HartnettMatt/PersonalProjects/AudioBalancer/README.txt

THIS AUDIO PROJECT IS RUNNING ON AN ARDUINO NANO EVERY. THE HARDWARE FOR THE SLIDERS IS BASED ON A RADIOSHACK 4 CHANNEL STEREO SOUND MIXER. THE SOFTWARE ORGINATES FROM THE DEEJ PROJECT ON GITHUB, BUT HAS BEEN MODIFIED BY ME FOR THE LINEARIZATION OF THE RADIOSHACK SLIDERS.
