HartnettMatt/PersonalProjects/Bathroom Organizer/FullOrganizer.FCStd

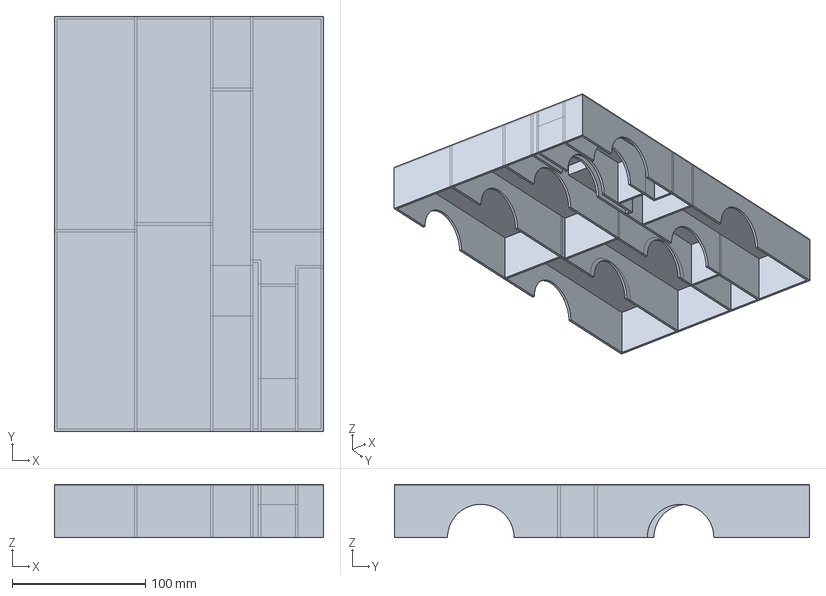
[picture p5: CAD file, 2025-11-11]
Bathroom Organizer/FullOrganizer.FCStd
202.0 x 312.0 x 40.0 mm
