HartnettMatt/PersonalProjects/Bathroom Organizer/Moisturizer.FCStd

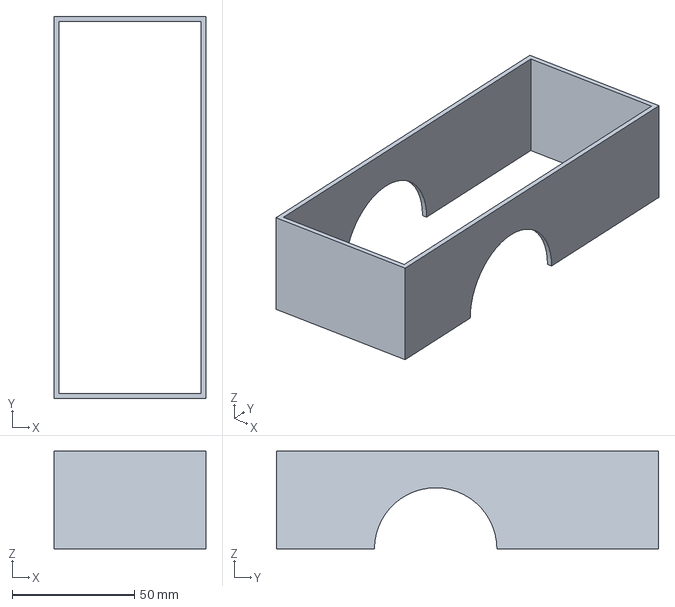
[picture p6: CAD file, 2025-11-11]
Bathroom Organizer/Moisturizer.FCStd
62.0 x 156.0 x 40.0 mm
