HartnettMatt/PersonalProjects/ESPHome/MotionDetector/3D/Enclosure.FCStd

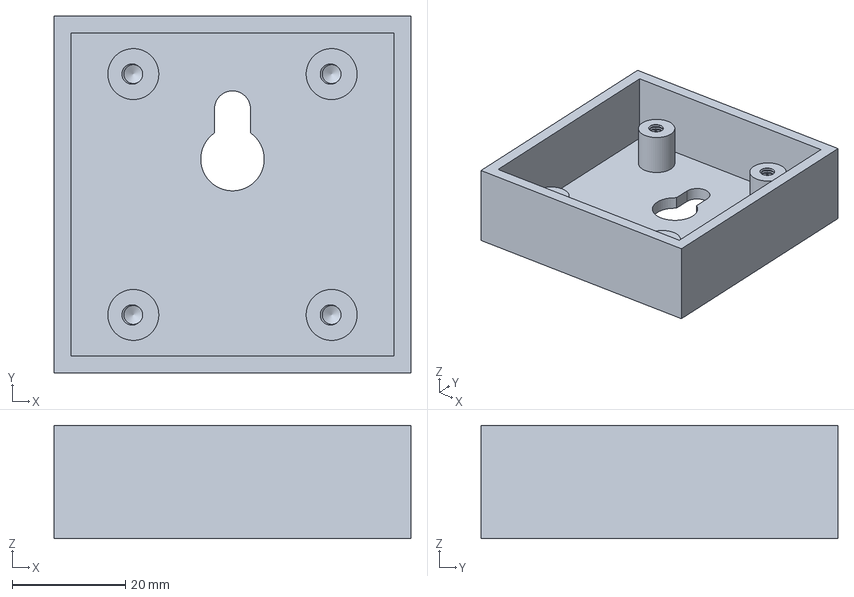
[picture p7: CAD file, 2025-05-09]
ESPHome/MotionDetector/3D/Enclosure.FCStd
63.0 x 63.0 x 20.0 mm
