HartnettMatt/PersonalProjects/ESPHome/MotionDetector/PCB/Parts/61302011821/6130XX11821_61302011821.step

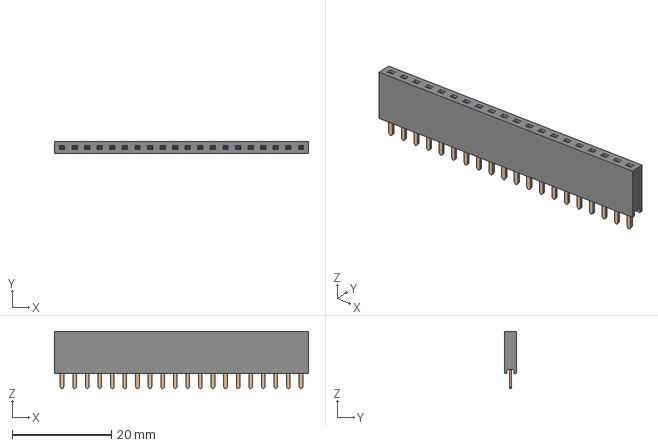
[picture p8: CAD file, 2024-12-29]
ESPHome/MotionDetector/PCB/Parts/61302011821/6130XX11821_61302011821.step
51.3 x 2.50 x 11.6 mm
6130xx11821_PIN x 20
