HartnettMatt/PersonalProjects/ESPHome/RGBStrip/PCB/AO3400A/AO3400A.step

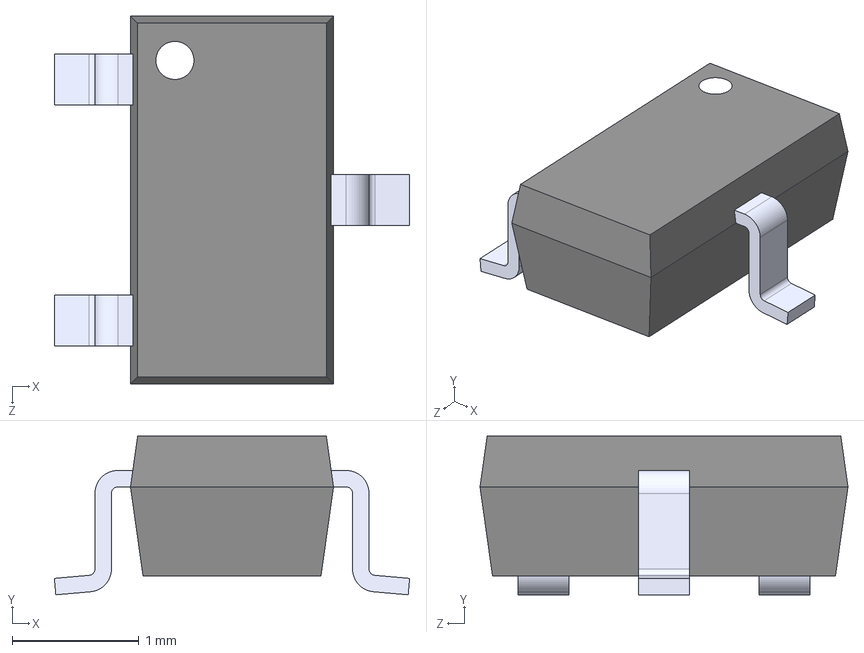
[picture p9: CAD file, 2025-08-09]
ESPHome/RGBStrip/PCB/AO3400A/AO3400A.step
2.80 x 1.25 x 2.90 mm
