HartnettMatt/PersonalProjects/Bathroom Organizer/Toothbrush.FCStd

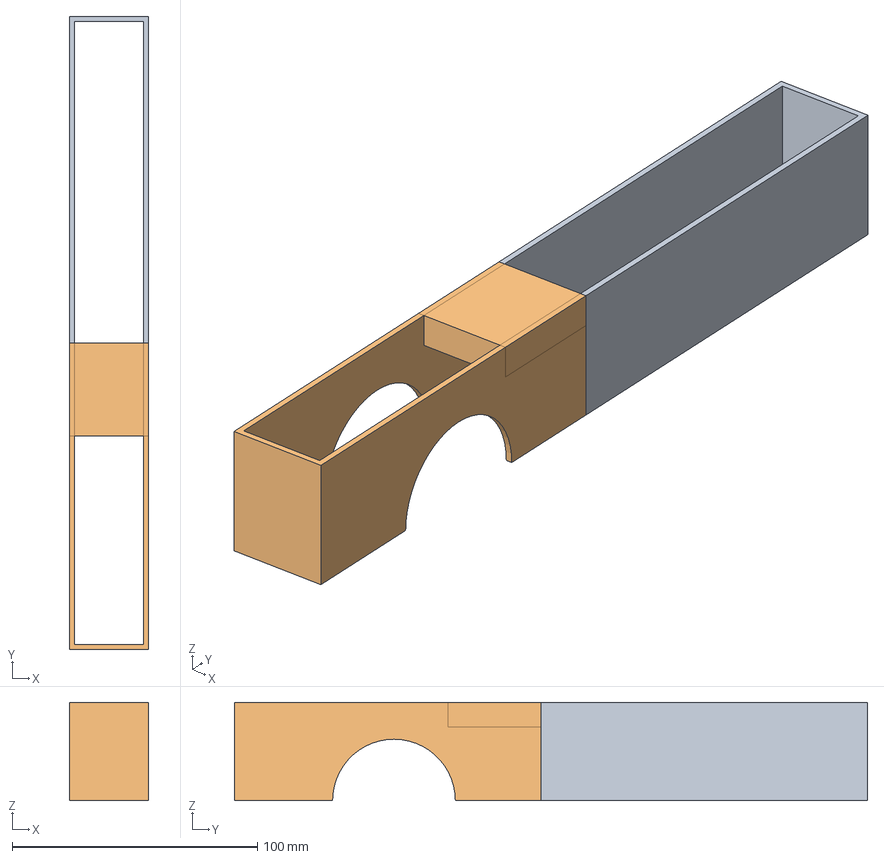
[picture p10: CAD file, 2025-11-11]
Bathroom Organizer/Toothbrush.FCStd
32.0 x 258.0 x 40.0 mm
Toothbrush001
