HartnettMatt/PersonalProjects/IRSender/IRSender.FCStd

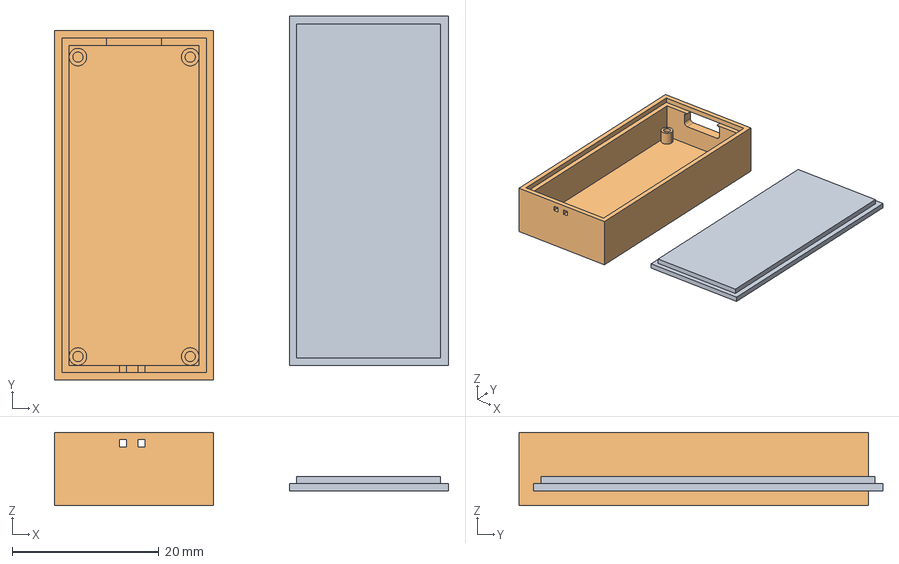
[picture p11: CAD file, 2025-05-13]
IRSender/IRSender.FCStd
53.7 x 49.6 x 10.0 mm
Lid
Box with LED cutout
