HartnettMatt/PersonalProjects/Bathroom Organizer/Razor.FCStd

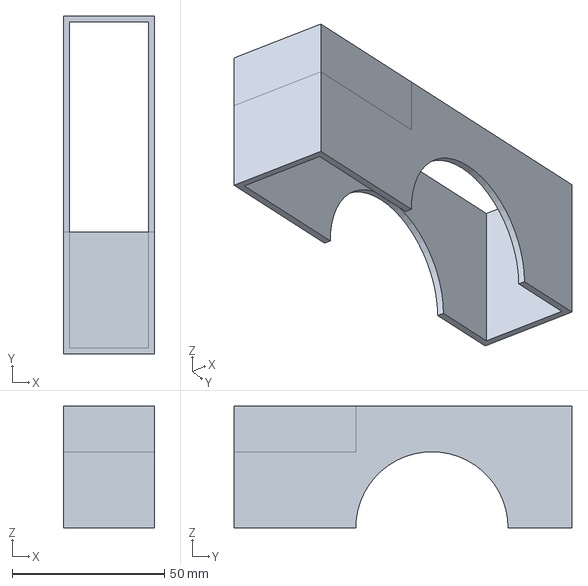
[picture p12: CAD file, 2025-03-21]
Bathroom Organizer/Razor.FCStd
30.0 x 111.0 x 40.0 mm
