HartnettMatt/PersonalProjects/Bathroom Organizer/Deodorent.FCStd

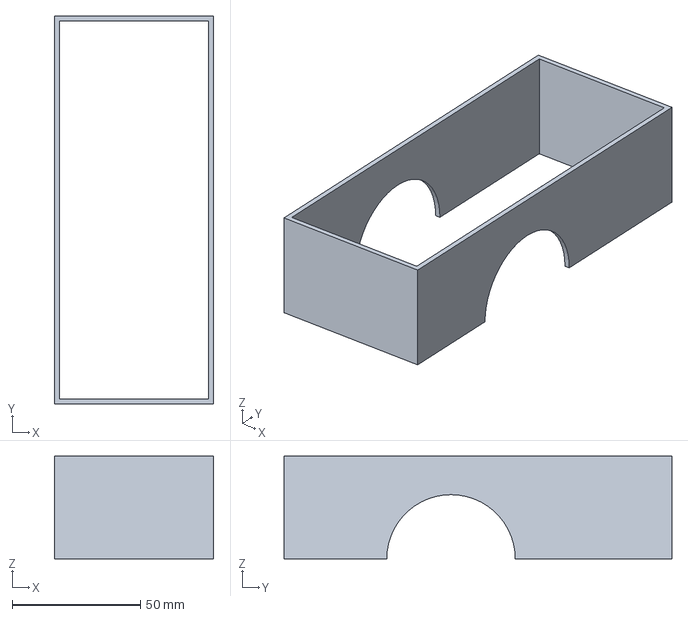
[picture p13: CAD file, 2025-03-21]
Bathroom Organizer/Deodorent.FCStd
62.0 x 151.0 x 40.0 mm
