HartnettMatt/PersonalProjects/IRSender/IRSender-Arduino Mount.stl

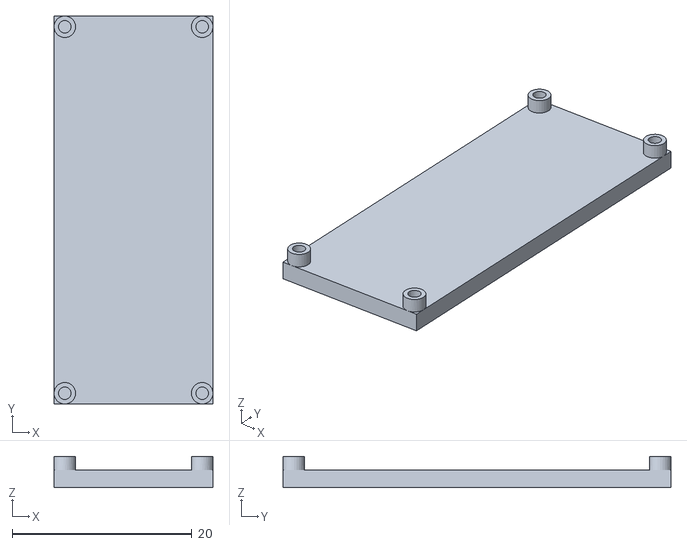
[picture p14: CAD file, 2025-05-13]
IRSender/IRSender-Arduino Mount.stl
17.7 x 43.2 x 3.50
