HartnettMatt/PersonalProjects/Bathroom Organizer/Toothbrush1.stl

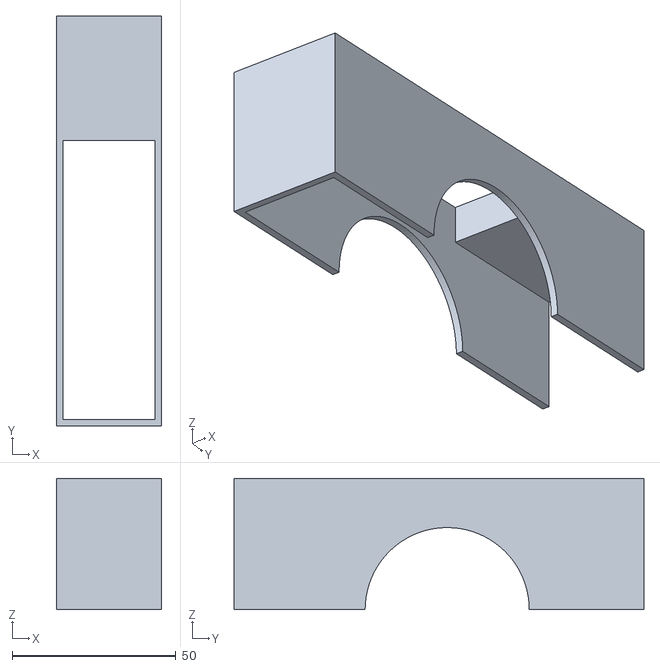
[picture p15: CAD file, 2025-03-21]
Bathroom Organizer/Toothbrush1.stl
32.0 x 125.0 x 40.0
