HartnettMatt/PersonalProjects/IRSender/IRSender-Arduino Box Lid.stl

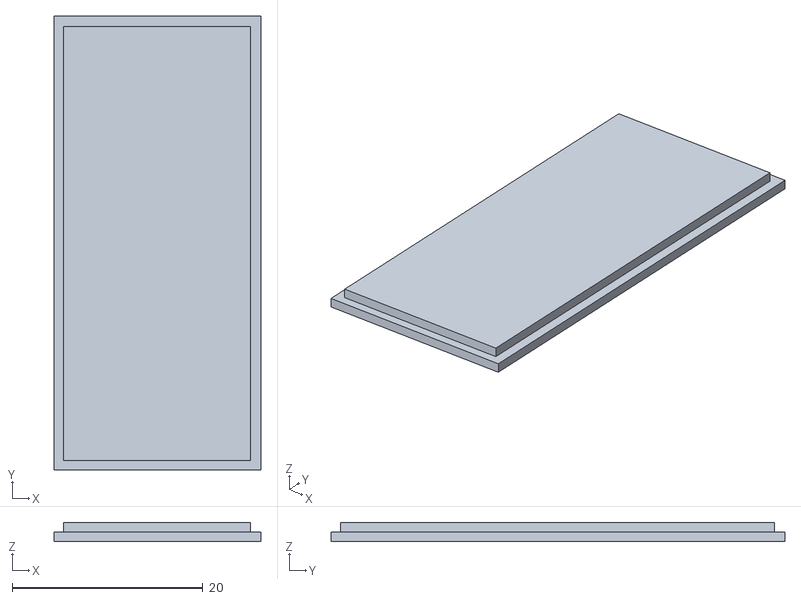
[picture p16: CAD file, 2025-05-13]
IRSender/IRSender-Arduino Box Lid.stl
21.7 x 47.6 x 2.00
