HartnettMatt/PersonalProjects/Bathroom Organizer/Bathroom Organizer.FCStd

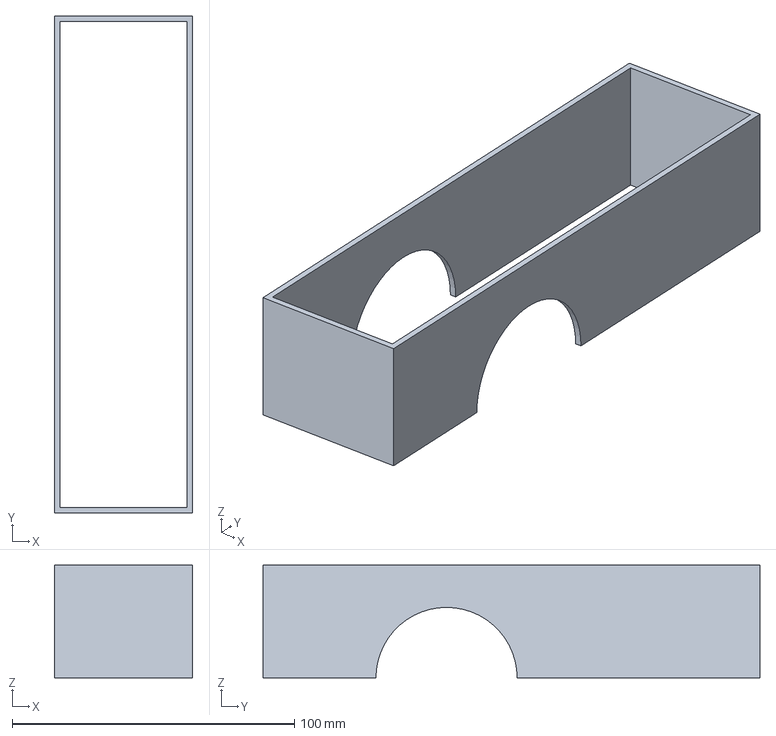
[picture p17: CAD file, 2025-03-21]
Bathroom Organizer/Bathroom Organizer.FCStd
49.0 x 176.0 x 40.0 mm
