HartnettMatt/PersonalProjects/Bathroom Organizer/Contacts.FCStd

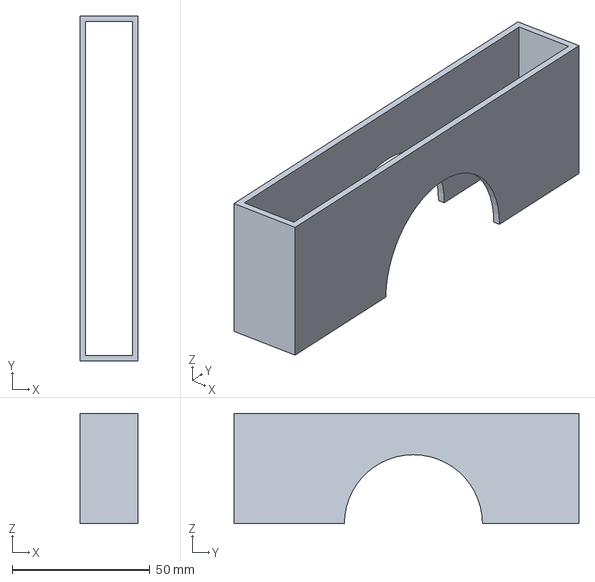
[picture p18: CAD file, 2025-03-21]
Bathroom Organizer/Contacts.FCStd
21.0 x 125.0 x 40.0 mm
