HartnettMatt/PersonalProjects/Bathroom Organizer/Toothbrush2.stl

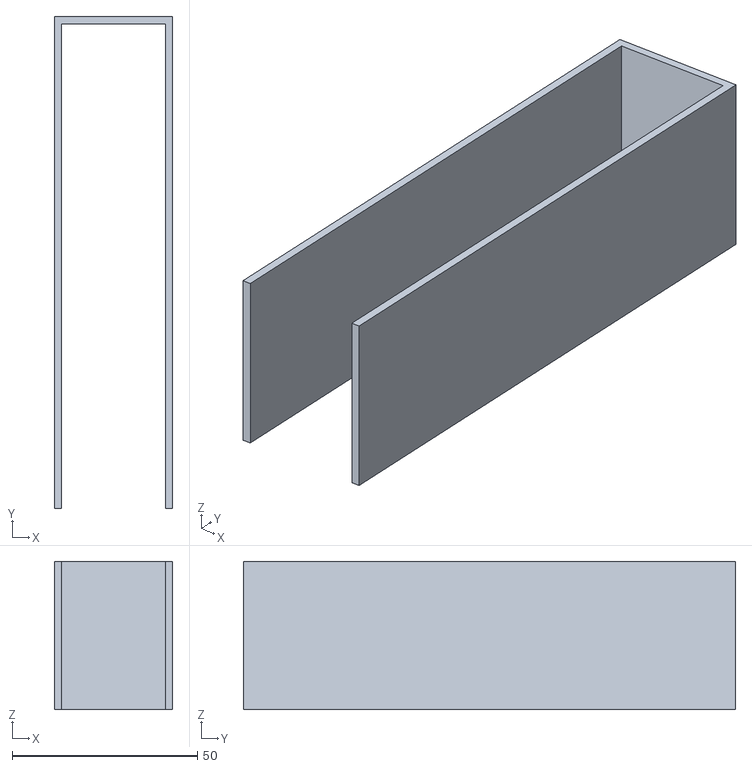
[picture p19: CAD file, 2025-03-21]
Bathroom Organizer/Toothbrush2.stl
32.0 x 133.0 x 40.0
