HartnettMatt/PersonalProjects/(list of files, cad)

Other CAD files:
PlantTrellis/PlantTrellis.FCStd
Bathroom Organizer/Contacts.stl
Bathroom Organizer/Deodorent.stl
Bathroom Organizer/FullOrganizer.stl
Bathroom Organizer/Moisturizer.stl
Bathroom Organizer/Razor.stl
Bathroom Organizer/Toothbrush.stl
ESPHome/MotionDetector/3D/Enclosure.stl
ESPHome/MotionDetector/PCB/Parts/215299-3/215299-3/3D/215299-3.stp
ESPHome/MotionDetector/PCB/Parts/215299-3/215299-3/Allegro/shdr3w78p0x254_1x3_772x252x850p.psm
ESPHome/MotionDetector/PCB/Parts/215299-3/215299-3/DEHDL/215299_3/chips/chips.prt
IRSender/IRSender-Arduino Box_v2.stl
IRSender/IRSender-Arduino Box_v3.stl
