HartnettMatt/PersonalProjects/Home Assistant/EVCharger/history.csv

entity_id | state | last_changed
sensor.us15_m2_16_32a_total_energy | 4.6 | 2025-09-01T06:00:00.000Z
sensor.us15_m2_16_32a_total_energy | 6.88 | 2025-09-01T07:00:00.000Z
sensor.us15_m2_16_32a_total_energy | 8.03 | 2025-09-01T08:00:00.000Z
sensor.us15_m2_16_32a_total_energy | 9.17 | 2025-09-01T09:00:00.000Z
sensor.us15_m2_16_32a_total_energy | 9.94 | 2025-09-01T10:00:00.000Z
sensor.us15_m2_16_32a_total_energy | 0 | 2025-09-01T11:00:00.000Z
sensor.us15_m2_16_32a_total_energy | 0 | 2025-09-01T12:00:00.000Z
sensor.us15_m2_16_32a_total_energy | 1.14 | 2025-09-01T23:00:00.000Z
sensor.us15_m2_16_32a_total_energy | 2.29 | 2025-09-02T00:00:00.000Z
sensor.us15_m2_16_32a_total_energy | 3.45 | 2025-09-02T01:00:00.000Z
sensor.us15_m2_16_32a_total_energy | 4.6 | 2025-09-02T02:00:00.000Z
sensor.us15_m2_16_32a_total_energy | 5.76 | 2025-09-02T03:00:00.000Z
sensor.us15_m2_16_32a_total_energy | 6.91 | 2025-09-02T04:00:00.000Z
sensor.us15_m2_16_32a_total_energy | 8.07 | 2025-09-02T05:00:00.000Z
sensor.us15_m2_16_32a_total_energy | 9.23 | 2025-09-02T06:00:00.000Z
sensor.us15_m2_16_32a_total_energy | 11.56 | 2025-09-02T07:00:00.000Z
sensor.us15_m2_16_32a_total_energy | 12.72 | 2025-09-02T08:00:00.000Z
sensor.us15_m2_16_32a_total_energy | 13.86 | 2025-09-02T09:00:00.000Z
sensor.us15_m2_16_32a_total_energy | 15 | 2025-09-02T10:00:00.000Z
sensor.us15_m2_16_32a_total_energy | 16.14 | 2025-09-02T11:00:00.000Z
sensor.us15_m2_16_32a_total_energy | 0 | 2025-09-02T12:00:00.000Z
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
sensor.us15_m2_16_32a_total_energy | 18.45 | 2025-09-29T11:19:06.562Z
sensor.us15_m2_16_32a_total_energy | 19.57 | 2025-09-29T12:11:52.048Z
sensor.us15_m2_16_32a_total_energy | 20.7 | 2025-09-29T13:04:37.589Z
sensor.us15_m2_16_32a_total_energy | 21.84 | 2025-09-29T13:57:23.212Z
sensor.us15_m2_16_32a_total_energy | 22.97 | 2025-09-29T14:50:08.533Z
sensor.us15_m2_16_32a_total_energy | 24.11 | 2025-09-29T15:42:53.564Z
sensor.us15_m2_16_32a_total_energy | 25.26 | 2025-09-29T16:35:38.912Z
sensor.us15_m2_16_32a_total_energy | 26.4 | 2025-09-29T17:28:24.481Z
sensor.us15_m2_16_32a_total_energy | 27.48 | 2025-09-29T18:17:49.450Z
sensor.us15_m2_16_32a_total_energy | 0.0 | 2025-09-29T19:07:37.825Z
