HartnettMatt/PersonalProjects/ESPHome/RGBStrip/PCB/ControlSchematic.asc

M1: nmos
M2: nmos
M3: nmos
Named nets: 0
