HartnettMatt/PersonalProjects/(list of files, drawings)

Other design files:
ESPHome/MotionDetector/PCB/Parts/215299-3/215299-3/Altium/215299-3.SchLib
ESPHome/MotionDetector/PCB/Parts/215299-3/215299-3/Altium/SHDR3W78P0X254_1X3_772X252X850P.PcbLib
