HartnettMatt/PersonalProjects/ESPHome/MotionDetector/PCB/MotionDetector/MotionDetector.kicad_pcb

## KiCad design ESPHome/MotionDetector/PCB/MotionDetector/MotionDetector.kicad_pcb (2024-12-29)

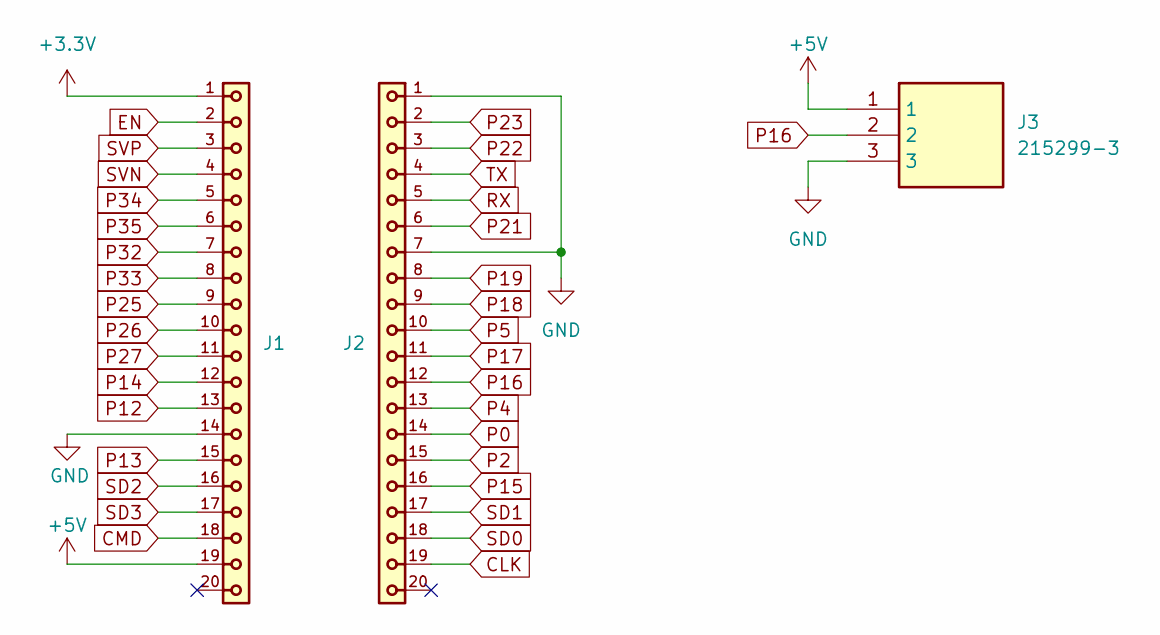
[picture p20: schematic MotionDetector.kicad_sch, ESPHome MotionDetector SCH]

Parts:
J1, J2: 61302011821; PART-NUMBER 61302011821
J3: 215299-3; SHDR3W78P0X254_1X3_772X252X850P; Mouser Part Number 571-215299-3

Connections:
+3.3V: J1.1
+5V: J1.19, J3.1
CLK: J2.19
CMD: J1.18
EN: J1.2
GND: J1.14, J2.1, J2.7, J3.3
P0: J2.14
P2: J2.15
P4: J2.13
P5: J2.10
P12: J1.13
P13: J1.15
P14: J1.12
P15: J2.16
P16: J2.12, J3.2
P17: J2.11
P18: J2.9
P19: J2.8
P21: J2.6
P22: J2.3
P23: J2.2
P25: J1.9
P26: J1.10
P27: J1.11
P32: J1.7
P33: J1.8
P34: J1.5
P35: J1.6
RX: J2.5
SD0: J2.18
SD1: J2.17
SD2: J1.16
SD3: J1.17
SVN: J1.4
SVP: J1.3
TX: J2.4

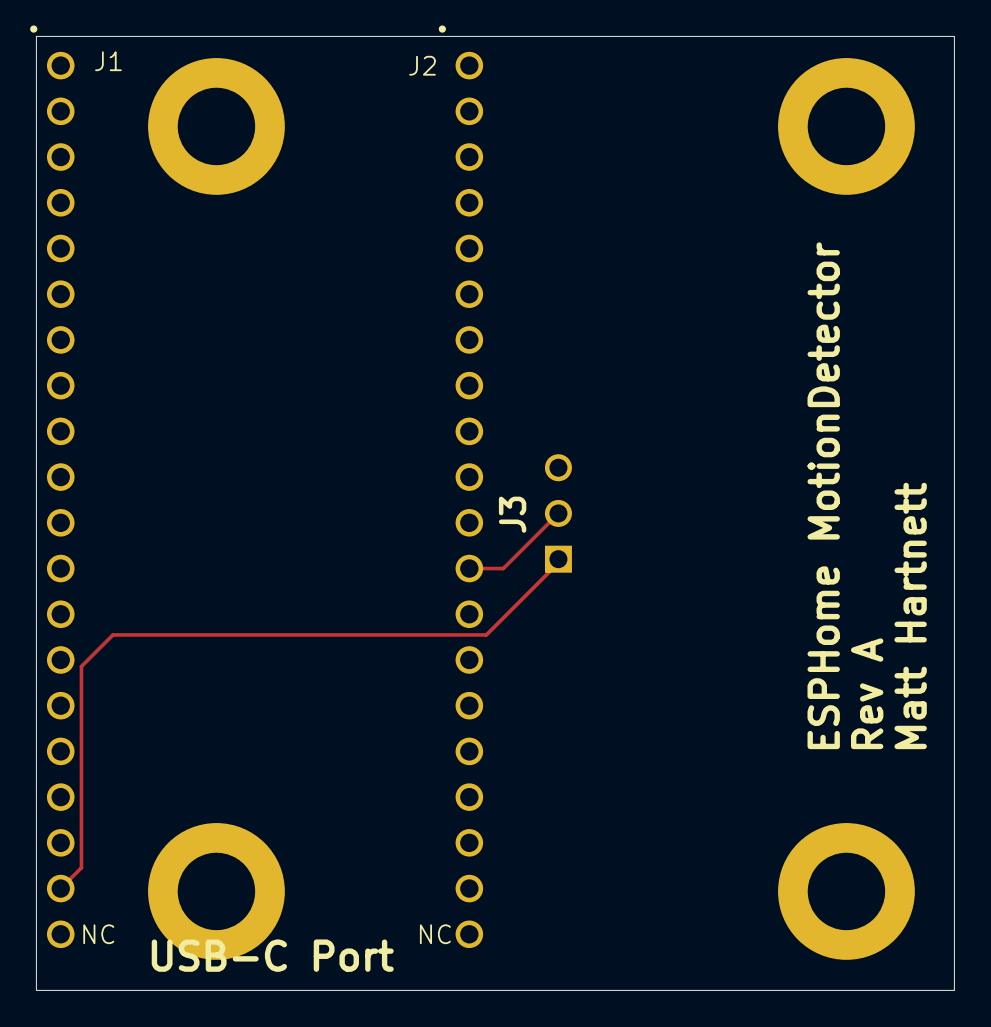
[picture p21: board MotionDetector.kicad_pcb from above]

Board: 2 copper layers, 51.0 x 53.0 mm, 3 parts (0 on the bottom side), 3 nets.
