HartnettMatt/PersonalProjects/Cocotb/SpiToAxi/obj_dir/Vspi2axi__main.cpp

// Verilated -*- C++ -*-
// DESCRIPTION: main() calling loop, created with Verilator --main

#include "verilated.h"
#include "Vspi2axi.h"

//======================

int main(int argc, char** argv, char**) {
    // Setup context, defaults, and parse command line
    Verilated::debug(0);
    const std::unique_ptr<VerilatedContext> contextp{new VerilatedContext};
    contextp->commandArgs(argc, argv);

    // Construct the Verilated model, from Vtop.h generated from Verilating
    const std::unique_ptr<Vspi2axi> topp{new Vspi2axi{contextp.get()}};

    // Simulate until $finish
    while (!contextp->gotFinish()) {
        // Evaluate model
        topp->eval();
        // Advance time
        contextp->timeInc(1);
    }

    if (!contextp->gotFinish()) {
        VL_DEBUG_IF(VL_PRINTF("+ Exiting without $finish; no events left\n"););
    }

    // Final model cleanup
    topp->final();
    return 0;
}
