HartnettMatt/PersonalProjects/Cocotb/SpiToAxi/obj_dir/Vspi2axi__Syms.cpp

// Verilated -*- C++ -*-
// DESCRIPTION: Verilator output: Symbol table implementation internals

#include "Vspi2axi__pch.h"
#include "Vspi2axi.h"
#include "Vspi2axi___024root.h"

// FUNCTIONS
Vspi2axi__Syms::~Vspi2axi__Syms()
{
}

Vspi2axi__Syms::Vspi2axi__Syms(VerilatedContext* contextp, const char* namep, Vspi2axi* modelp)
    : VerilatedSyms{contextp}
    // Setup internal state of the Syms class
    , __Vm_modelp{modelp}
    // Setup module instances
    , TOP{this, namep}
{
    // Configure time unit / time precision
    _vm_contextp__->timeunit(-12);
    _vm_contextp__->timeprecision(-12);
    // Setup each module's pointers to their submodules
    // Setup each module's pointer back to symbol table (for public functions)
    TOP.__Vconfigure(true);
}
