HartnettMatt/PersonalProjects/Cocotb/SpiToAxi/obj_dir/Vspi2axi___024root__Slow.cpp

// Verilated -*- C++ -*-
// DESCRIPTION: Verilator output: Design implementation internals
// See Vspi2axi.h for the primary calling header

#include "Vspi2axi__pch.h"
#include "Vspi2axi__Syms.h"
#include "Vspi2axi___024root.h"

void Vspi2axi___024root___ctor_var_reset(Vspi2axi___024root* vlSelf);

Vspi2axi___024root::Vspi2axi___024root(Vspi2axi__Syms* symsp, const char* v__name)
    : VerilatedModule{v__name}
    , vlSymsp{symsp}
 {
    // Reset structure values
    Vspi2axi___024root___ctor_var_reset(this);
}

void Vspi2axi___024root::__Vconfigure(bool first) {
    if (false && first) {}  // Prevent unused
}

Vspi2axi___024root::~Vspi2axi___024root() {
}
