HartnettMatt/PersonalProjects/Cocotb/SpiToAxi/obj_dir/Vspi2axi__pch.h

// Verilated -*- C++ -*-
// DESCRIPTION: Verilator output: Precompiled header
//
// Internal details; most user sources do not need this header,
// unless using verilator public meta comments.
// Suggest use Vspi2axi.h instead.


#ifndef VERILATED_VSPI2AXI__PCH_H_
#define VERILATED_VSPI2AXI__PCH_H_  // guard

// GCC and Clang only will precompile headers (PCH) for the first header.
// So, make sure this is the one and only PCH.
// If multiple module's includes are needed, use individual includes.
#ifdef VL_PCH_INCLUDED
# error "Including multiple precompiled header files"
#endif
#define VL_PCH_INCLUDED


#include "verilated.h"

#include "Vspi2axi__Syms.h"
#include "Vspi2axi.h"

#endif  // guard
