HartnettMatt/PersonalProjects/(commit log)

2024-02-01 Made great progress, fully tested basic write sequence, found a couple bugs
    [monitor.py, spi2axi.sv, tb.py]
2024-12-29 Added README and ESPHome
    [MotionDetector.kicad_pcb, MotionDetector.kicad_sch]
2024-12-29 Finished first revsion of the PCB for the motion detector project
    [215299-3.SchLib, 215299-3.stp, 6130XX11821_61302011821.step, EDI2CAP.CFG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]
2024-12-30 Began working on enclosure
    [Enclosure.FCStd]
2025-01-06 Added screw standoffs
    [Enclosure.FCStd]
2025-03-21 Finished some 3D printer designs
    [Bathroom Organizer.FCStd, Contacts.FCStd, Contacts.stl, Deodorent.FCStd, Deodorent.stl, Moisturizer.FCStd, Moisturizer.stl, PlantTrellis.FCStd]
2025-05-09 Re-printed Toothbrush as one piece
    [Toothbrush.FCStd, Toothbrush.stl]
2025-05-09 Finished up MotionDetector
    [Enclosure.FCStd, Enclosure.stl]
2025-05-13 Finished 3D print for IRSender, also makes a decent starting point for generic Arduino Nano mount
    [IRSender-Arduino Box Lid.stl, IRSender-Arduino Box.stl, IRSender-Arduino Box_v2.stl, IRSender-Arduino Box_v3.stl, IRSender-Arduino Box_v4.stl, IRSender-Arduino Mount.stl, IRSender.FCStd]
2025-05-15 Fixed second IR code for Max
    [IRSender.ino]
2025-08-09 Started work on RGB Strip project
    [AO3400A.step]
2025-08-11 Created my first Home Assistant project, an automation and python script to track and compute EV charging cost
    [history.csv]
2025-09-05 Started work on a CanvasBot that can hopefully help me backup files from Canvas and easily get class materials onto my local machine
2025-09-10 Tightend margins a bit
2025-11-11 Designed a new full bathroom organizer
    [FullOrganizer.FCStd, FullOrganizer.stl, Moisturizer.FCStd, Toothbrush.FCStd]
2025-11-11 Updated ev charging history
    [history.csv]
